helpquick/ReVerSE-U9/u9_specialist/readme.txt

Реализация ПК Специалист (сборка 20160114)
Портирование на ReVerSE-U9: MVV

20160103 Modified for ReVerSE-U9 By MVV
20160114 BIOS-SD Corrected By ivagor

Основана на версии "specIvaGor250215" для Altera DE1, автор ivagor (Иван Городецкий),
"Spetsialist_MX_FPGA beta version (31.01.2012)",
Авторы: Fifan (Виталий Онуфрович), Ewgeny7 (Евгений Иванов), HardWareMan (Игорь Внуков)
[www.zx.pk.ru](http://www.zx.pk.ru), [www.spetsialist-mx.ru](http://www.spetsialist-mx.ru)

Использована реализация ("хард" и софт) работы с SD Дмитрия Целикова (b2m) [bashkiria-2m.narod.ru](http://bashkiria-2m.narod.ru/)

Использованный PAL-кодер базируется на проекте vector06cc [vector06cc](https://code.google.com/p/vector06cc/)
Вячеслава Славинского [svofski](http://sensi.org/~svo)

Видео: Аппаратный скандаблер VGA 720х576 50 Гц
Звук: TDA1543 (192kHz) 2Ch
SD: 2GB (FAT16)
PS/2: Клавиатура (разъем возле питания)

Для загрузки программы с SD:
1) После включения, жмем 'F1', потом 'ENTER'
2) Вводим 'GD000'
3) Две команды: 'DIR' и 'СD'
4) Запускаем *.rks (в формате без имени, можно скачать например здесь - http://emu80.org/dl.html)

Тестирование:
Для проверки правильности цветопередачи можно использовать приложенный файл test8c.rks. Он рисует стандартные цветные полосы: белый, желтый, голубой, зеленый, пурпурный, красный, синий, черный.

Не все VGA мониторы поддерживают 50Гц развертку. Т.к. режим нестандартный, потребуется подстройка (один раз, затем монитор запомнит). При подстройке монитора (автоматической или ручной) удобно использовать приложенный файл *border.rks* (рисует рамку, ограничивающую активную область изображения)
