helpquick/ReVerSE-U9/u9_board/images/u9_bot01.jpg

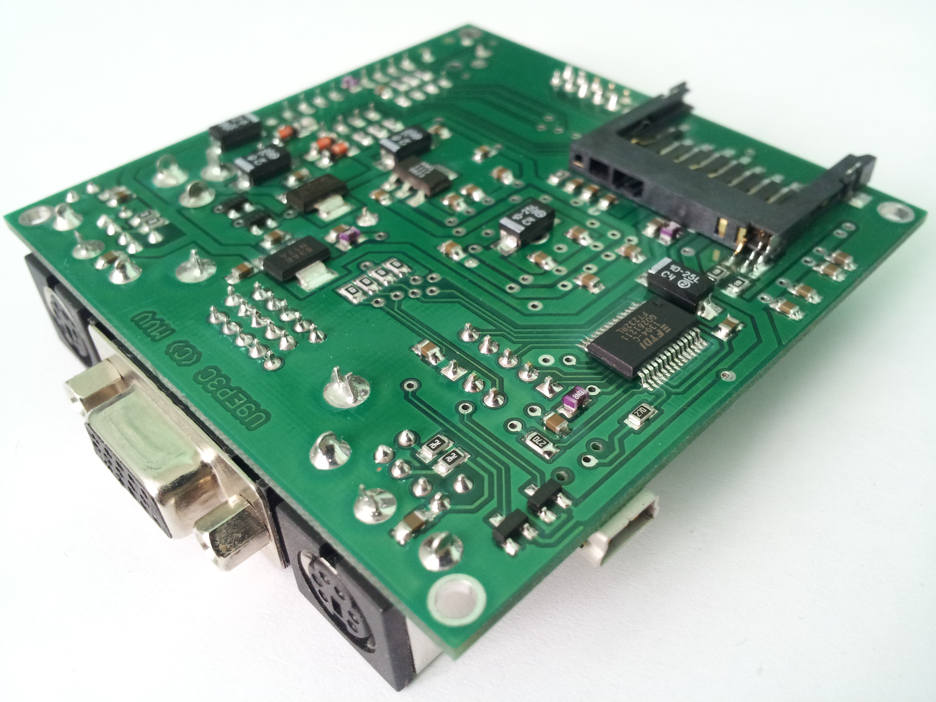
u9_board/images/u9_bot01.jpg
