helpquick/ReVerSE-U9/u9_board/images/u9_top01.jpg

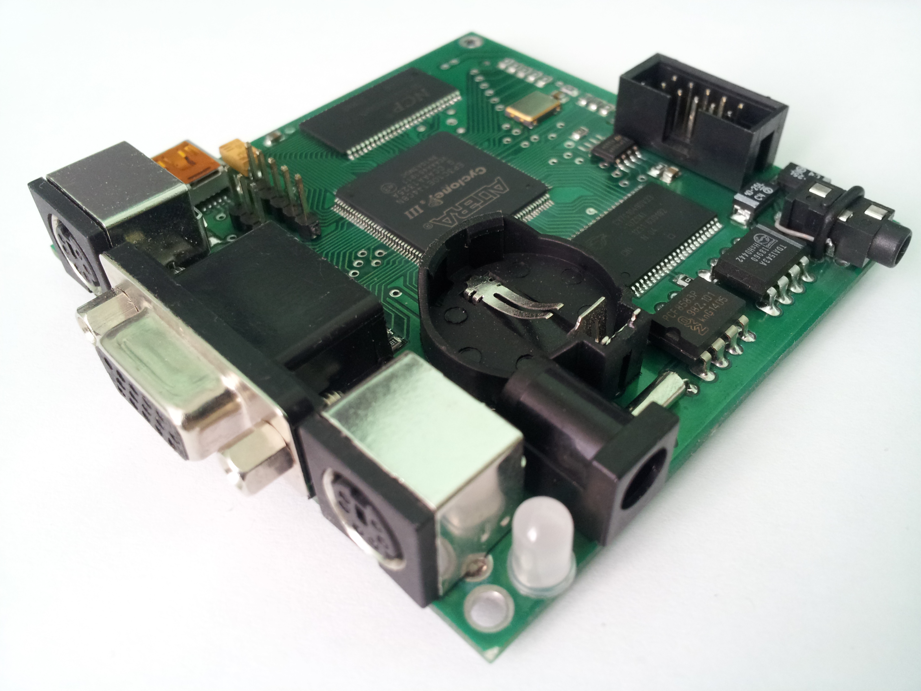
u9_board/images/u9_top01.jpg
