helpquick/ReVerSE-U9/u9_tsconf/rtl/rtc/CMOS_TRDOS/TR-DOS.JPG

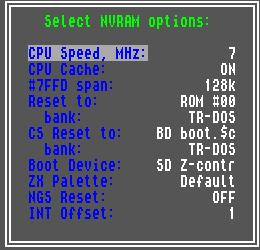
u9_tsconf/rtl/rtc/CMOS_TRDOS/TR-DOS.JPG
