helpquick/ReVerSE-U9/u9_tsconf/rtl/rtc/CMOS_VTRDOS/WC vs VTRDOS.JPG

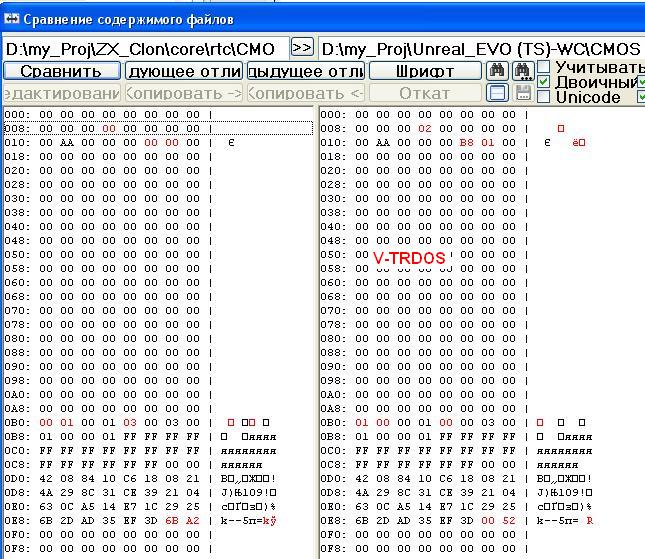
u9_tsconf/rtl/rtc/CMOS_VTRDOS/WC vs VTRDOS.JPG
