helpquick/ReVerSE-U9/u9_tsconf/rtl/rtc/CMOS_WC/WC.JPG

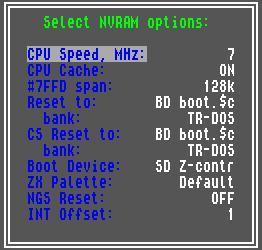
u9_tsconf/rtl/rtc/CMOS_WC/WC.JPG
