helpquick/ReVerSE-U9/u9_board/manuals/U9EP3C FPGA Development Kit (en).pdf

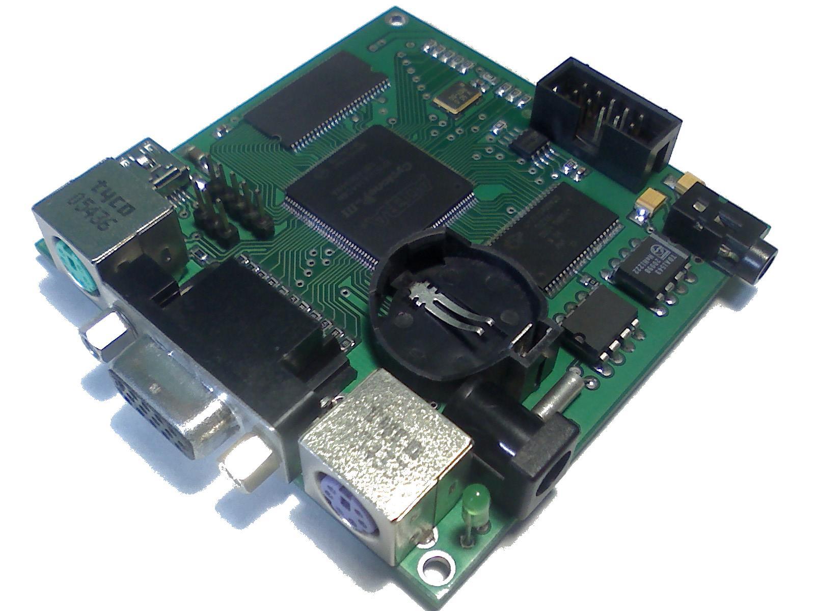
[picture p12: figure]

# U9EP3CFPGA Development Kit

# User Manual

## U9EP3C User Manual

# 1.1 Layout and Components

This chapter presents the features and design characteristics of the U9EP3C board.

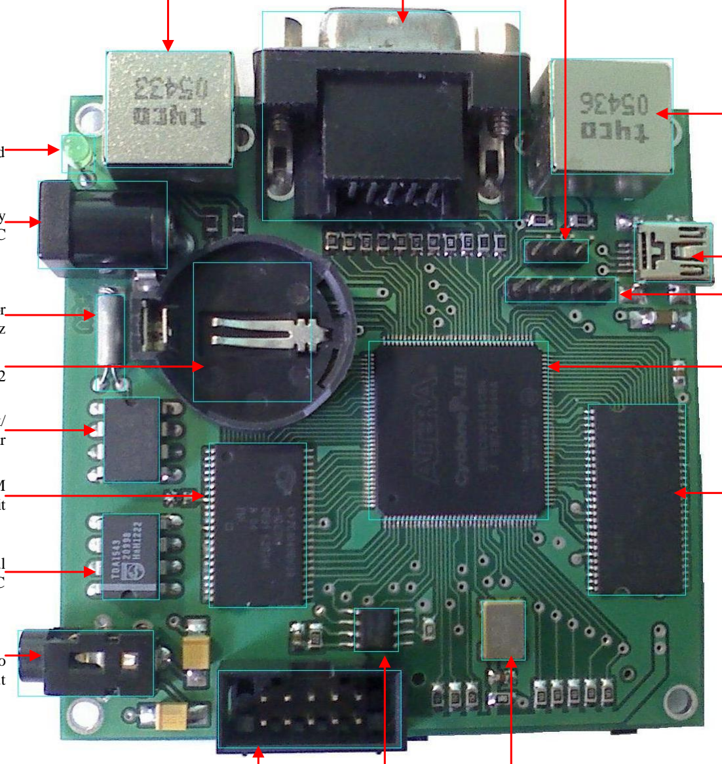
[picture p13: figure]

## Figure 1.1. The U9EP3C board (top side)

## A photograph of the U9EP3C board is shown in Figure 1.1-1.2. It depicts the layout of the

board and indicates the location of the connectors and key components.

## The following hardware is provided on the U9EP3C board:

## Altera Cyclone® III 3C10 FPGA device

## Altera Serial Configuration device – 512-Kbyte SPI Flash memory M25P40 (EPCS4)

## JTAG for programming and user API control; both and Active Serial (AS) programming

## modes are supported

## 32-Mbyte 8-bits SDRAM

## 512-Kbyte 8-bits SRAM memory

## SD Card socket

PS/2 Port

USB-UART

VGA

Power Led

Power Supply
5V DC

Oscillator
32.768KHz

Battery CR2032

Clock/
Calendar

SRAM
512K x 8 bit

I2S Dual
16 bit DAC

Audio stereo
Output

SDRAM
32M x 8 bit

Cyclone III
EP3C10

PS/2 Port

JTAG | SPI FLASH 512K

50MHz
Oscillator

Reset/GPI

## 1 green power LED

## 50-MHz oscillator for clock sources

## VGA DAC (3-bit resistor network) with VGA-out connector

## USB – UART (RS-232 transceiver)

## Dual 16-bit I2S DAC

## Audio stereo output

## 2 PS/2 ports for mouse and keyboard connectors

## 1 GPI

## 1 Reset input

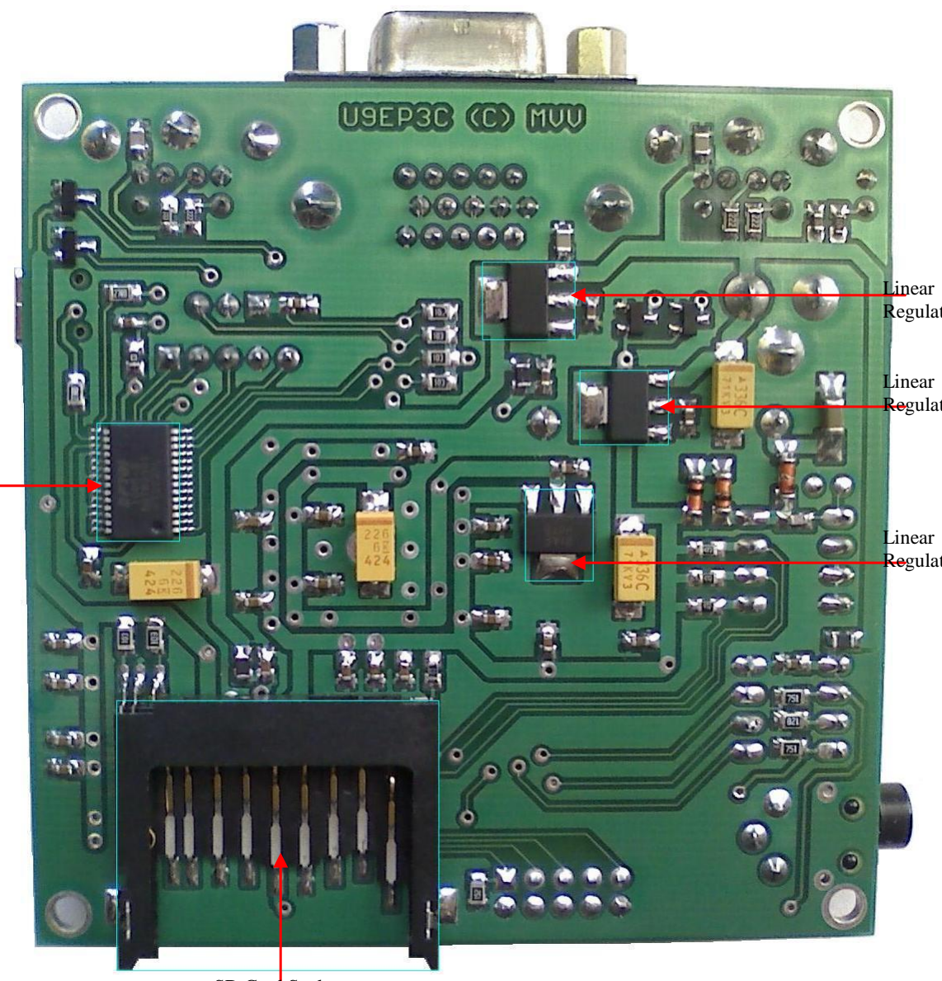
[picture p14: figure]
Linear

## Figure 1.2. The U9EP3C board (bottom side)

USB – UART

Regulator 2.5V

Regulator 3.3V

Regulator 1.25V

SD Card Socket

# Appendix 2.1 ByteBlasterMV Schematic

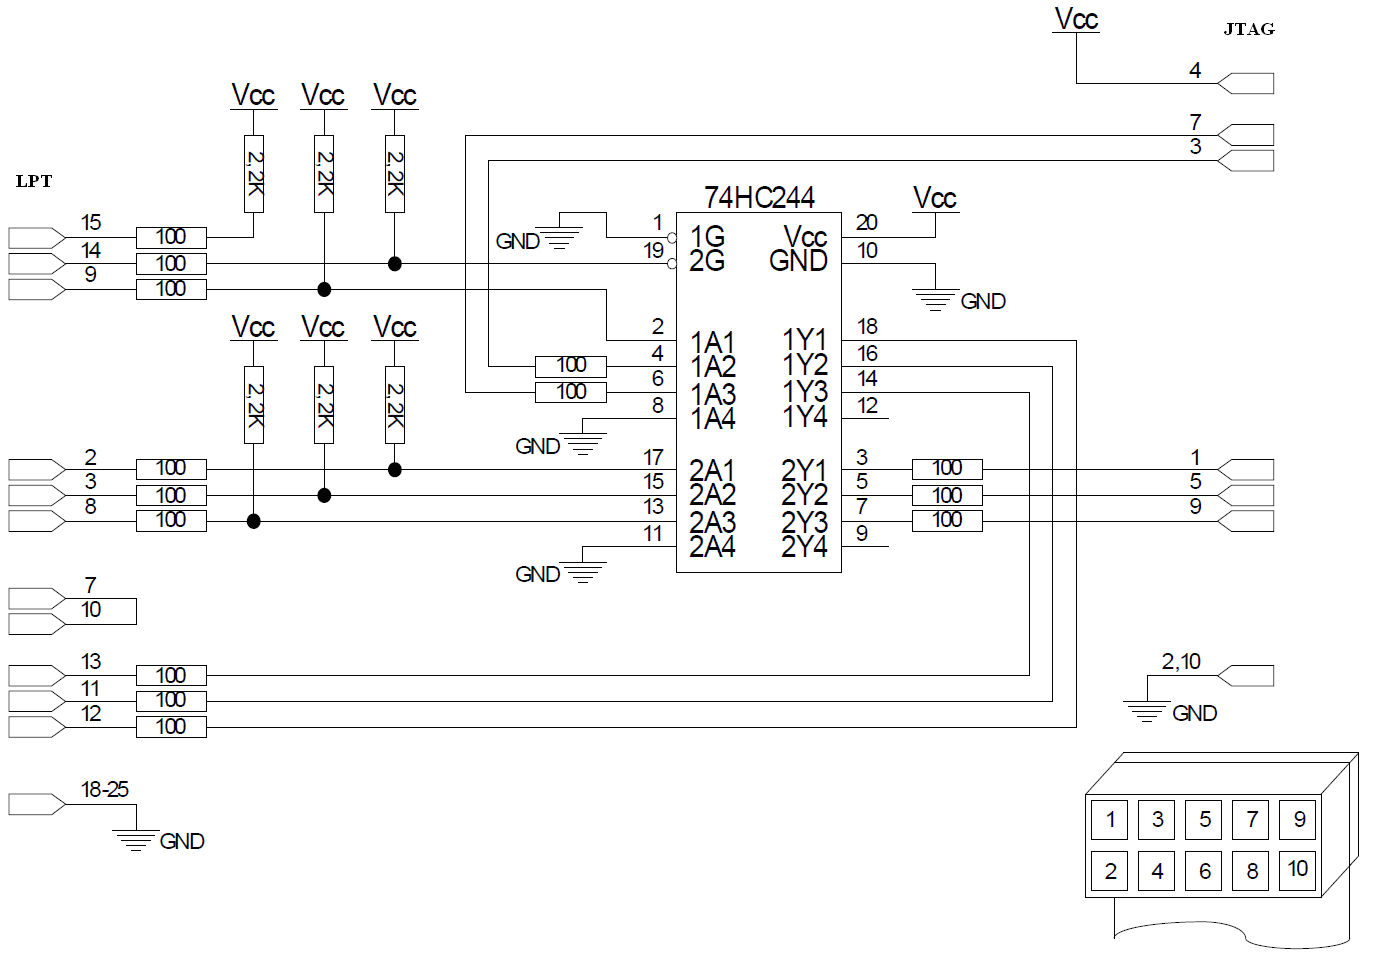
[picture p15: figure]

## ByteBlasterMV Female Plug’s Pin Names & Download Modes

Pin | PS Mode | JTAG Mode
Signal Name | Description | Signal Name | Description
1 | DCLK | Clock signal | TCK | Clock signal
2 | GND | Signal ground | GND | Signal ground
3 | CONF_DONE | Configuration control | TDO | Data from device
4 | VCC | Power supply | VCC | Power supply
5 | nCONFIG | Configuration control | TMS | JTAG state machine control
6 | - | No connect | - | No connect
7 | nSTATUS | Configuration status | - | No connect
8 | - | No connect | - | No connect
9 | DATA0 | Data to device | TDI | Data to device
10 | GND | Signal ground | GND | Signal ground

# Components

LED1 : LED3MM : LED (green) | VD3 : BAT54S : SOT23 | Resistors
Q3 : 32.768kHz : TC38H | VD4 : BAT54S : SOT23 | 0R : 1
QG1 : 50MHz : SM77H | VD5 : 1N4148 : SMA-DO214AC | 1R : 1
| VD6 : 1N4148 : SMA-DO214AC | 27R : 3
G1 : CR2032HH : CR2032 | VD7 : 1N4148 : SMA-DO214AC | 120R : 6
J1 : JACK-PLUG1 : SPC4078 | | 470R : 4
JP1 : Reset/GPI : Jumper 1-3 | L1 : 10NH : I0805 | 750R : 2
| L2 : 10NH : I0805 | 820R : 1
X1 : PS/2 Mouse : SSV-BC06 | L3 : 10NH : I0805 | 1K : 3
X2 : PS/2 Keyboard : SSV-BC06 | L4 : 10NH : I0805 | 1K2 : 3
X3 : FPS009-3000 : FPS009-3000 | | 1K8 : 3
X4 : VGA : HDF15H | R1 : 750R : R0805 | 2K4 : 8
X5 : ML10 : ML10 | R2 : 750R : R0805 | 10K : 13
X6 : STEREO-JACK : PJ-311 | R3 : 820R : R0805
X7 : MINI-USB : 32005-201 | R4 : 27R : R0805 | Capacitors
X9 : CBUS : Jumper 1-5 | R5 : 0 : R0805 | 5pF : 1
| R6 : 27R : R0805 | 100nF : 33
IC1 : LM1117-2.5-0.8A : SOT223 | R7 : 10K : R0805 | 10mF/6V : 4
IC2 : PCF8583P : DIL08 | R8 : 10K : R0805 | 100mF/6V : 4
IC3 : EP3C10E144 : EQFP144 | R9 : 10K : R0805
IC4 : M25P40 : SOIC8 | R10 : 120R : R0805 | Diode
IC5 : MT48LC32M8A2-TG : TSOP54-400 | R11 : 470R : R0805 | BAT54S : 4
IC6 : CY7C1049DV33T : TSOPII-Z44 | R12 : 2K4 : R0805 | 1N4148 : 3
IC7 : TDA1543 : DIL08 | R13 : 120R : R0805 | LED 3mm (green) : 1
IC8 : LM1117-1.2-0.8A : SOT223 | R14 : 120R : R0805
IC9 : LM1117-3.3-0.8A : SOT223 | R15 : 2K4 : R0805 | Inductances
IC10 : FT232RL : SSOP28 | R16 : 2K4 : R0805 | 10NH : 4
| R17 : 2K4 : R0805
C1 : 100nF : C0805 | R18 : 2K4 : R0805 | Oscillators
C2 : 100nF : C0805 | R19 : 2K4 : R0805 | 32.768kHz : 1
C3 : 100nF : C0805 | R20 : 470R : R0805 | 50MHz : 1
C4 : 100mF/6V : CT7343 | R21 : 10K : R0805
C5 : 100nF : C0805 | R22 : 27R : R0805 | Connectors
C6 : 100nF : C0805 | R23 : 10K : R0805 | SSV-BC06 : 2
C7 : 100nF : C0805 | R24 : 2K4 : R0805 | CR2032HH : 1
C8 : 100nF : C0805 | R25 : 2K4 : R0805 | SPC4078 : 1
C9 : 100nF : C0805 | R26 : 10K : R0805 | FPS009-3000 : 1
C10 : 100nF : C0805 | R27 : 10K : R0805 | HDF15H : 1
C11 : 10mF/6V : CT6032 | R28 : 10K : R0805 | ML10 : 1
C12 : 10mF/6V : CT6032 | R29 : 120R : R0805 | PJ-311 : 1
C13 : 100nF : C0805 | R30 : 470R : R0805 | Mini-USB : 1
C14 : 100nF : C0805 | R31 : 1K8 : R0805 | Jumper 1-3 : 1
C15 : 100nF : C0805 | R32 : 1K2 : R0805 | Jumper 1-5 : 1
C16 : 100mF/6V : CT7343 | R33 : 1K2 : R0805
C17 : 100mF/6V : CT7343 | R34 : 1K : R0805 | Stabilizers
C18 : 100nF : C0805 | R35 : 1K2 : R0805 | LM1117-1.2-0.8A :1
C19 : 100nF : C0805 | R36 : 1K8 : R0805 | LM1117-2.5-0.8A :1
C20 : 100nF : C0805 | R37 : 1K : R0805 | LM1117-3.3-0.8A :1
C21 : 100nF : C0805 | R38 : 1R : R0805
C22 : 100nF : C0805 | R39 : 1K8 : R0805 | Chips
C23 : 100nF : C0805 | R40 : 1K : R0805 | PCF8583P : 1
C24 : 100nF : C0805 | R41 : 10K : R0805 | EP3C10E144 : 1
C25 : 100nF : C0805 | R42 : 120R : R0805 | M25P40 : 1
C26 : 100nF : C0805 | R43 : 120R : R0805 | MT48LC32M8A2 : 1
C27 : 100nF : C0805 | R44 : 10K : R0805 | CY7C1049DV33 : 1
C28 : 5pF : C0805 | R45 : 10K : R0805 | TDA1543 : 1
C29 : 10mF : CT6032 | R46 : 10K : R0805 | FT232RL : 1
C30 : 100nF : C0603 | R47 : 470R : R0805
C31 : 100nF : C0805 | R48 : 10K : R0805
C32 : 100nF : C0805
C33 : 100nF : C0805 | Notes:
C34 : 100mF/6V : CT7343 | C42 : 4.7mF/6V <> 10mF/6V
C35 : 100nF : C0805 | LED1 : LED3MM <> LED5MM (red)
C36 : 100nF : C0805 | R30 : 470R <> 2K4
C37 : 100nF : C0805 | IC3 : EP3C10E144 <> EP3C5E144
C38 : 100nF : C0805 | IC4 : M25P40 <> EPCS4
C39 : 100nF : C0805 | IC5 : MT48LC32M8A2 <> MT48LC64M8A2
C40 : 100nF : C0805 | IC6 : CY7C1049DV33 <> CY7C1059DV33
C41 : 100nF : C0805 | VD1..4 : BAT54SW <> BAT54S
C42 : 4.7mF : CT6032 | Packaging Marking:
| LM1117-1.2-0.8A = N03A/N03B
VD1 : BAT54S : SOT23 | LM1117-2.5-0.8A = N13A
VD2 : BAT54S : SOT23 | LM1117-3.3-0.8A = N05A/N05B

# Board Top View

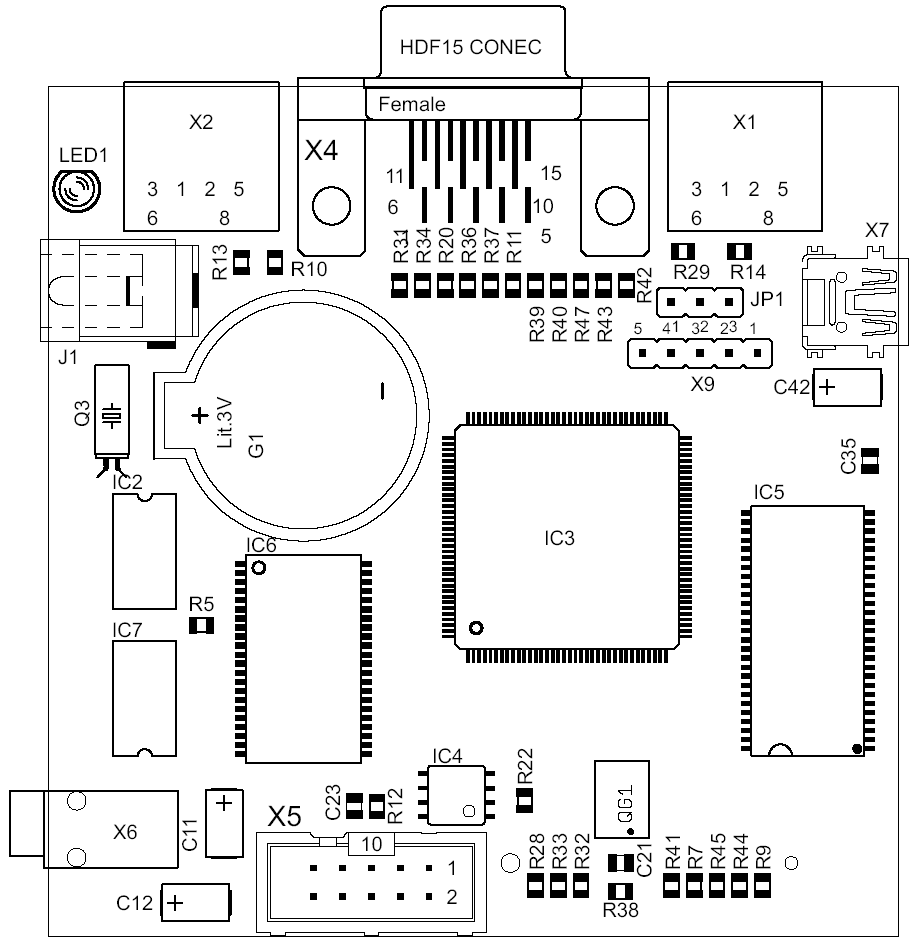
[picture p16: figure]

# Board Bottom View

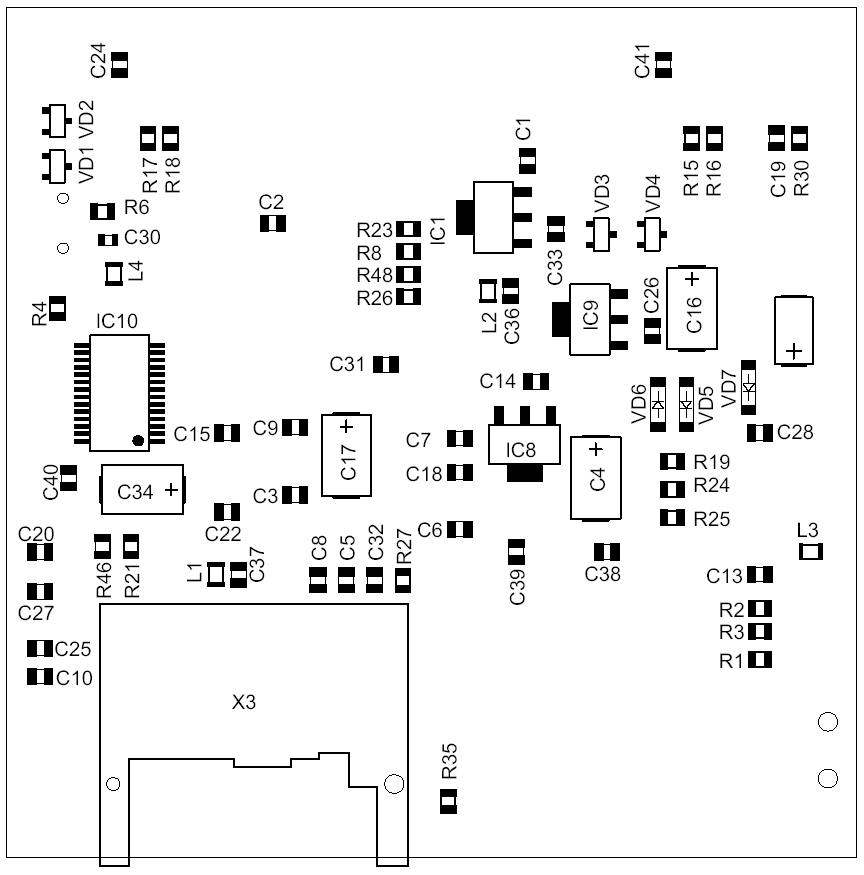
[picture p17: figure]

# Schematics

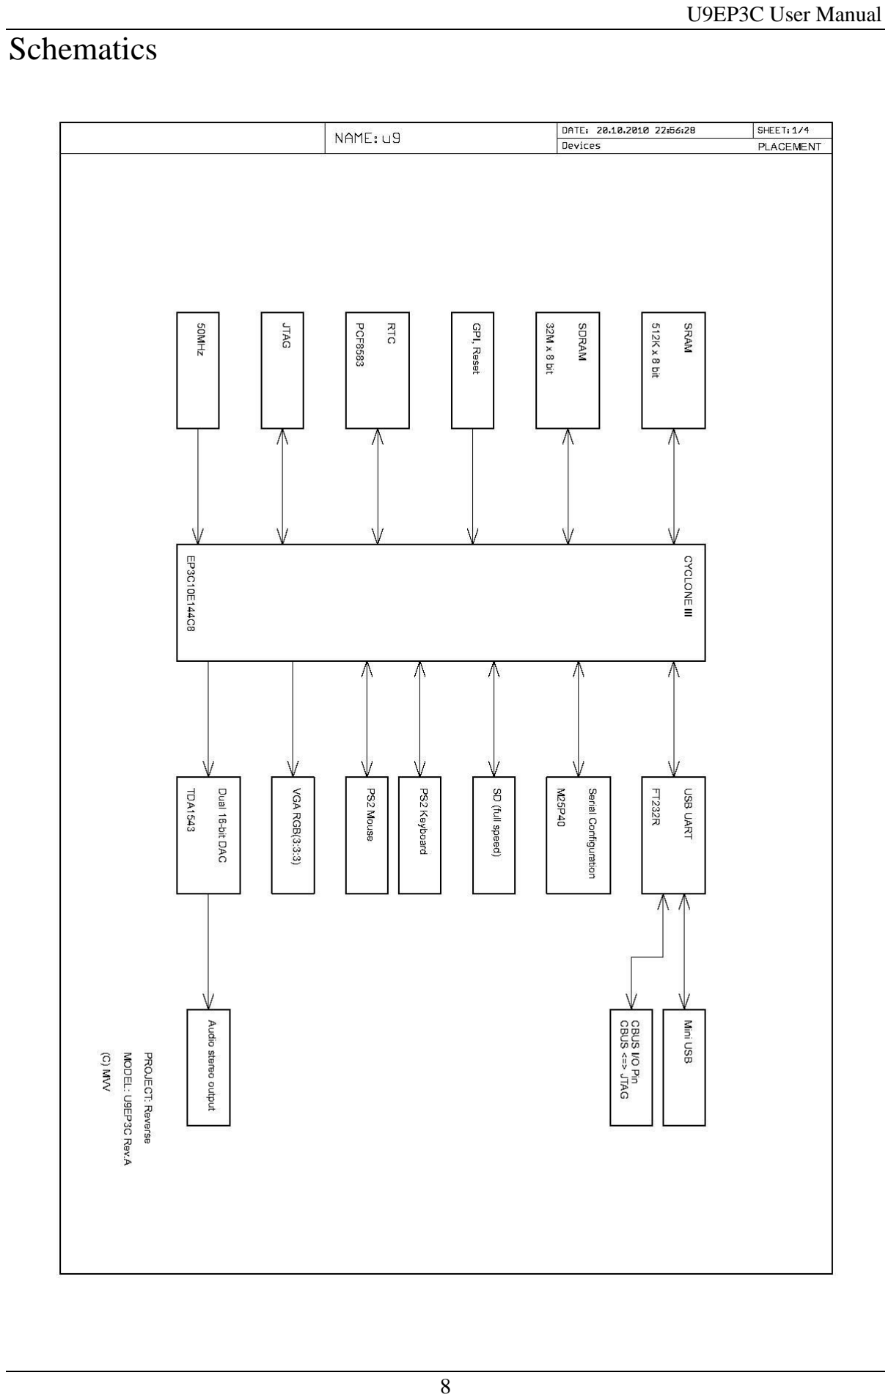
[picture p18: page 8]
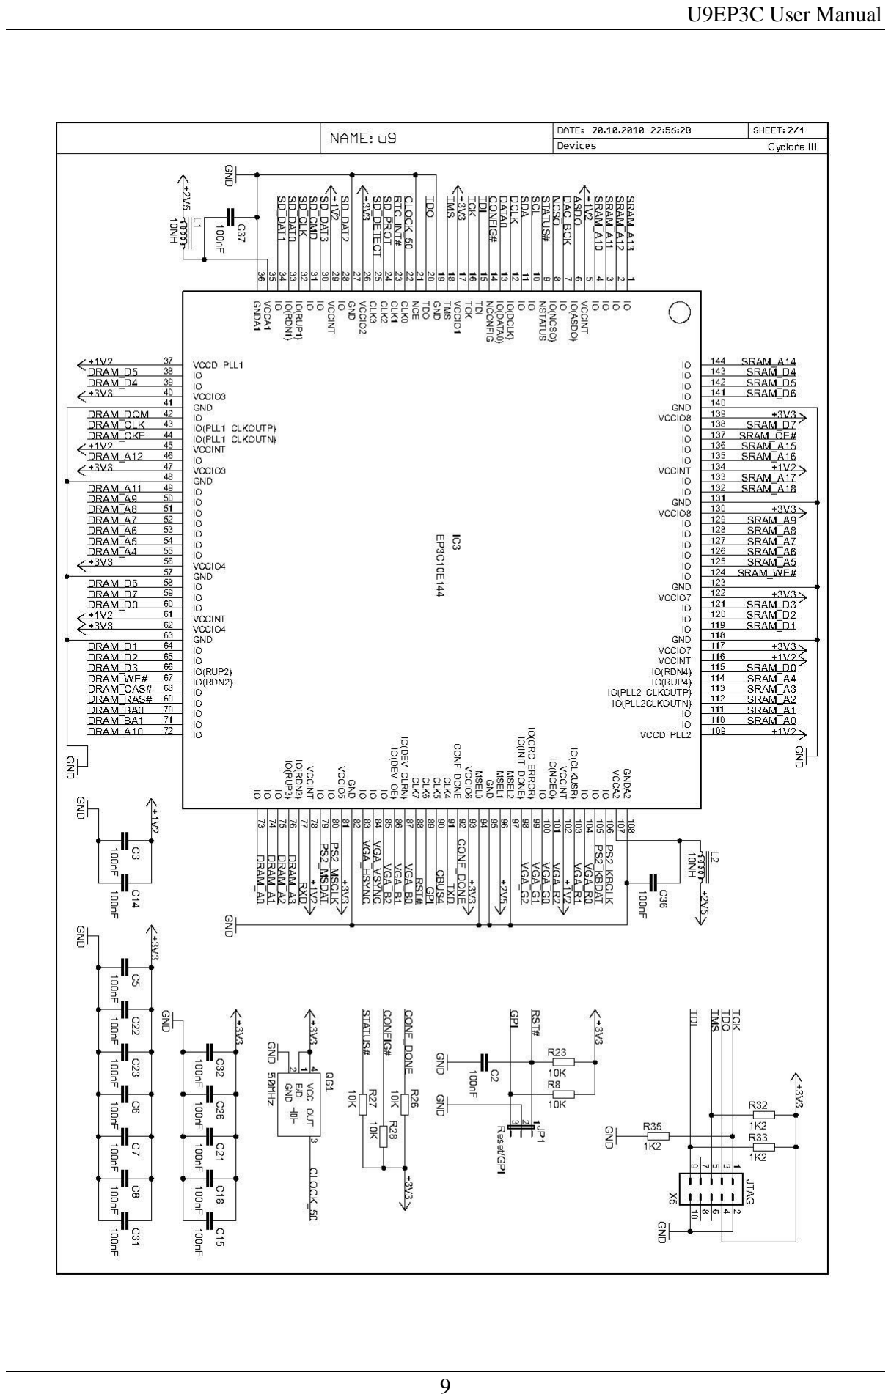
[picture p19: page 9]
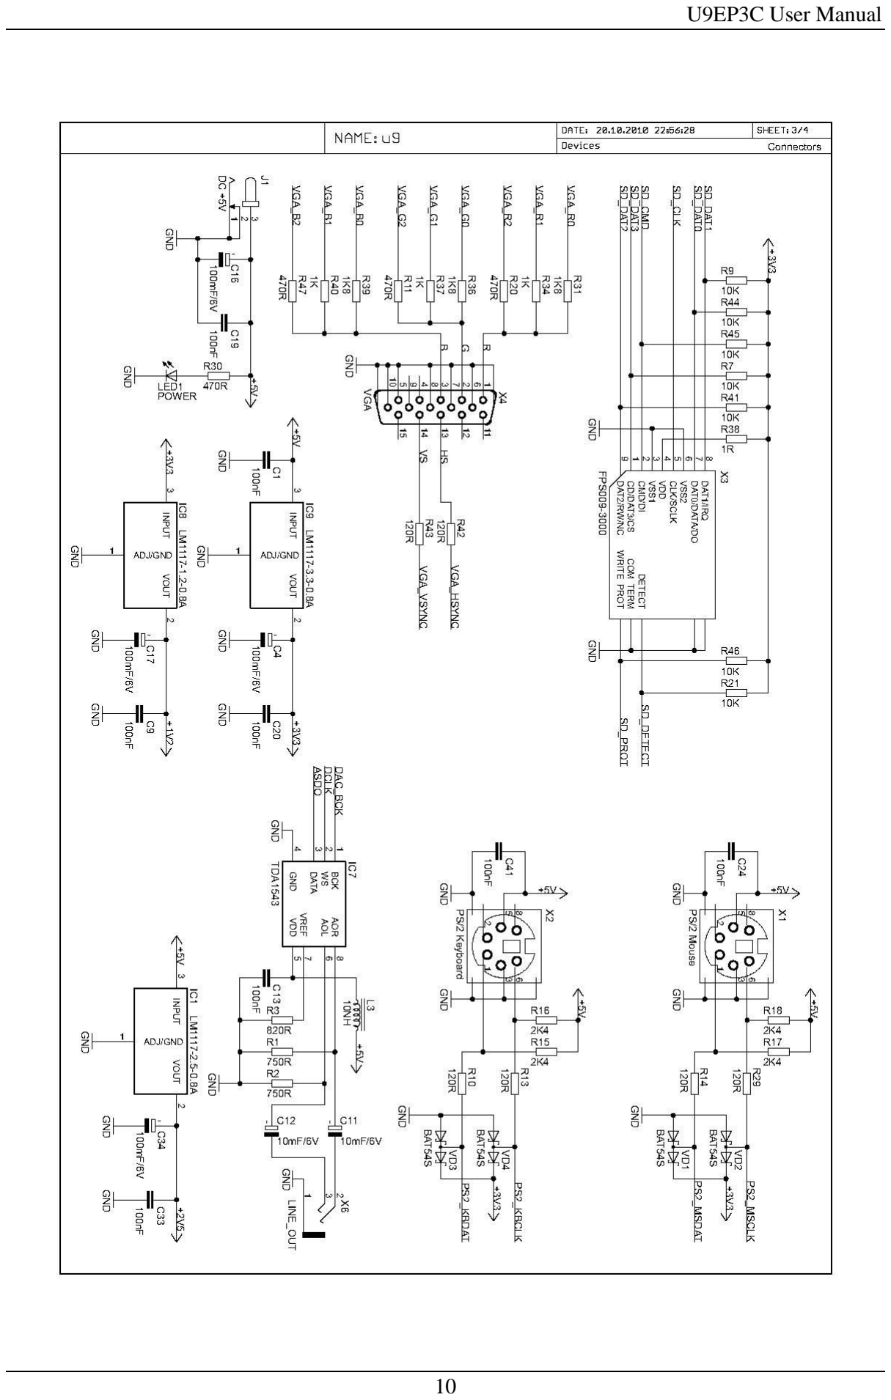
[picture p20: page 10]
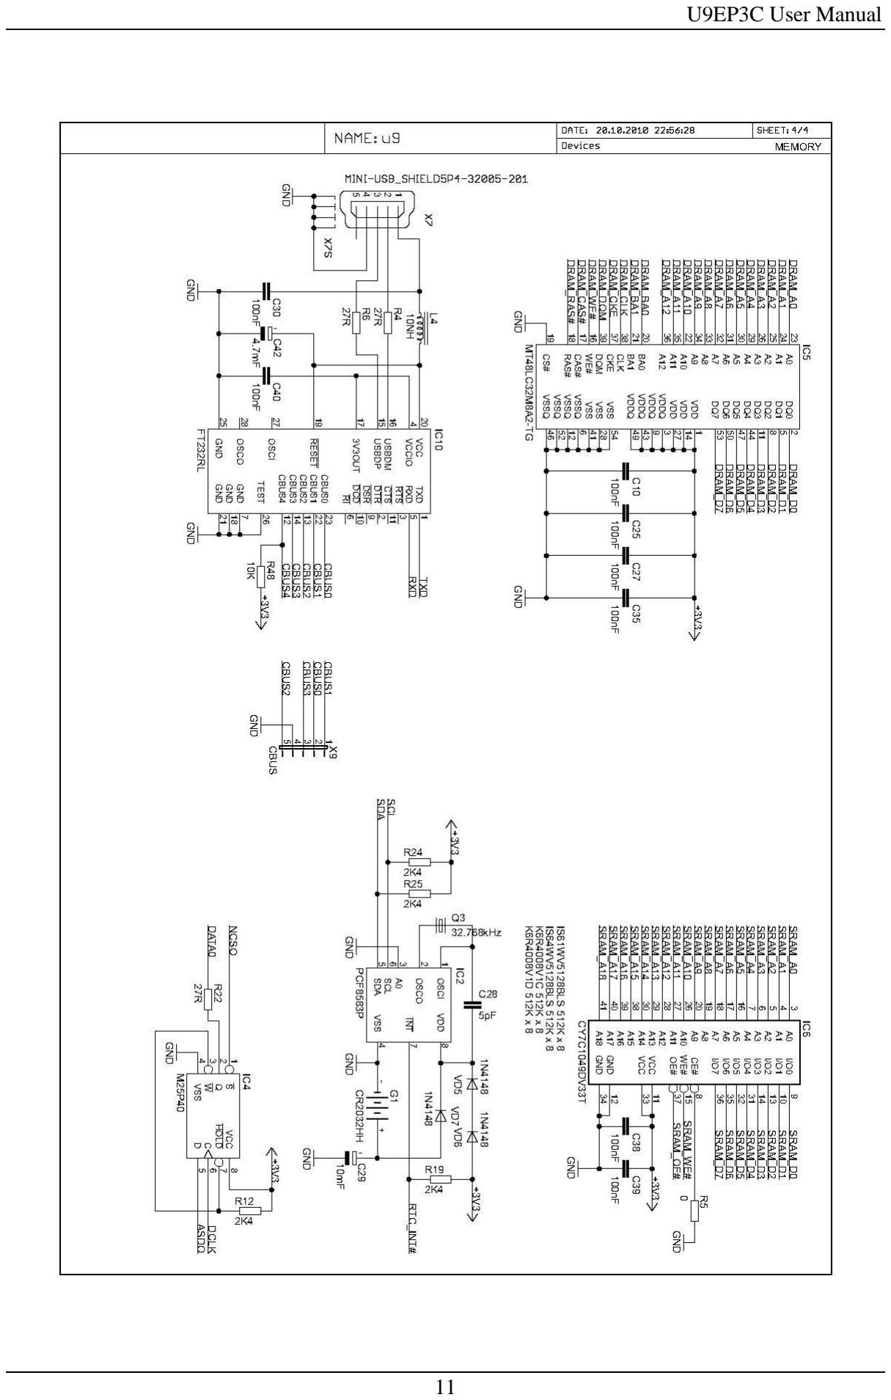
[picture p21: page 11]

# 2.2 Getting Help

## Here are the addresses where you can get help if you encounter problems:

## http://zx.pk.ru/showthread.php?t=13875

## http://zx.pk.ru/showthread.php?t=8993

## mvvproject@gmail.com

# 2.3 Revision History

Version | Change Log
V1.0 | Initial Version

# 2.4 Copyright Statement

Copyright © 2010 MVV.
