helpquick/ReVerSE-U9/(commit log)

2015-03-21 Конвертор BIN в HEX
2015-03-21 Шрифт для загрузчика
2015-03-21 Загрузчик
2015-03-21 Нет коментария
    [TSconf.xls]
2015-03-25 Added GERBER files
    [u9.drl, u9_Drills.xln, u9_Holes.xln]
2015-08-27 Added NES
    [nesdbg.sdf]
